AudricDenbroeder/LockerCracker/Rapport/DenbroederAudric_Rapport_PBE.pdf

Locker Cracker • June 2020

# Locker Cracker

Denbroeder Audric

HE2B - ISIB
audric96@gmail.com

Abstract

Mots clés— Cadenas, servomoteur, modèle 3D, OCR, tesseract, raspberry pi

I. Introduction

Pour le cours de projet et bureau d’étude
il m’a été demandé de réaliser un "hacker" de code de cadenas manuel. Ce genre de "robot" existant déjà pour un cadenas de type circulaire, je devais le réaliser sur un cadenas style européen, c’est-à-dire un simple cadenas avec 3-4 chiffres allant de 0 à 9. La façon de réaliser ce projet était libre, je n’avais aucune contrainte, si ce n’est d’utiliser un moteur. Je vais donc expliquer ici les différentes parties de projet qui sont les suivantes :
- L’électronique
- La modélisation 3D
- L’informatique

II. Electronique

Dès le début du projet un choix à du être posé : Comment faire pour tourner les chiffres du cadenas. Deux solutions ont été retenues. La première était d’utiliser un moteur utilisant des pinces pour tenir les chiffres et ensuite de faire tourner soit le cadenas soit les pinces pour que les chiffres tournent. Un peu comme un humain le ferait avec 2 doigts. La deuxième était d’utiliser un moteur avec une roue, que l’on mettrait juste à côté des chiffres, en faisant tourner la roue, la roue des chiffres tourneraient avec.
J’ai donc testé les deux solutions très rapidement après le début du projet. Finalement la deuxième solution était bien plus prometteuse que la première, les pinces n’avaient pas assez de couple disponible pour pouvoir tenir la roue du cadenas et la faire tourner en même temps. Cependant la roue n’avait aucun problème pour faire tourner les chiffres. Le moteur utilisé est le : FS5103R. La roue ayant été utilisée durant ce test est celle disponible avec le servomoteur.
Après avoir réalisé le modèle 3D (cela sera expliqué par la suite), un problème est survenu : L’adhésion de la roue à la roue du chiffre du cadenas. Celle-ci n’était pas parfaite ce qui avait pour conséquence de ne pas faire tourner les chiffres de manière constante. En effet cela se faisait parfois de la bonne façon on passait de 0 à 1 puis à 2, mais à d’autre moment l’adhésion n’étant plus parfaite, le chiffre passait de 2 à 4 ou simplement de 2 à 2.5 (La position milieu bloquant le cadenas).
Pour pallier ce problème mes professeurs m’ont suggéré l’idée d’utiliser une reconnaissance d’image pour lire les chiffres du cadenas. L’idée est que cela ne soit plus le servomoteur qui soit le cerveau et dicte la "cadence", à savoir faire du chiffre par chiffre. Mais plutôt la reconnaissance d’image, celle-ci regardera si il y’a un chiffre : Si non on demande au servomoteur d’avancer, si oui on vérifie le code.
Le projet qui se passait pour le moment sur Arduino utilisera donc une Raspberry Pi afin d’utiliser la camera de celle-ci pour la reconnaissance d’image (Qui sera expliqué plus en détail dans la partie informatique)
Pour faciliter la reconnaissance d’image un "flash" sera présent sur le modèle 3D, ce flash est constitué de LED. Les différentes parties de l’électronique est donc constitué de :
- Une raspberry pi
- Des leds
- Un servo-moteur (par rangée de chiffre)

1

III. Modélisation 3D

La modélisation 3D était une grande partie de ce projet car elle prenait beaucoup de temps durant le développement. En premier lui j’ai dû modéliser un caisson pour tenir le cadenas et le servomoteur proche l’un de l’autre, de façon à ce que la roue du servo soit collée à la roue des chiffres. Pour cela j’ai du aussi modéliser le cadenas :


Figure 1: Modèle 3D du cadenas

Ainsi que de modéliser le servomoteur et sa roue :


Figure 2: Modèle FS5103R

Pour avoir au final le 1er modèle :


Figure 3: Modèle FS5103R

C’est avec ce modèle que le problème d’adhésion a été détecté, en effet sans ce modèle il est impossible de savoir si l’adhésion est problématique. La cause est que l’on pourrait mal tenir le servomoteur et le cadenas l’un à côté de l’autre.

La réalisation de ce modèle a aussi permis de découvrir que la roue par défaut était beaucoup trop large, en effet celle-ci empiète sur l’une des deux autres rangée de chiffre lorsque mise sur celle du milieu. La solution a donc été de modéliser des nouvelles roues en 3D.

Malheureusement l’engrenage du servomoteur sur lequel la roue venait se fixer était impossible à reproduire en 3D, car beaucoup trop précis. Il a fallu donc être astucieux. Avec le servomoteur un kit est donné, celui-ci présente plusieurs éléments qui peuvent être ajouté à l’engrenage du servomoteur. On retrouve des petites roues, des barres horizontales, etc. Ce qui a été choisis est un morceau quadratique (Voir Figure 4), le but est donc de le modéliser en 3D et de creuser la roue modélisée en 3D avec ce modèle quadratique. Pour qu’une fois la roue imprimée l’on puisse mettre le morceau quadratique "dans" la roue et accrocher le tout au servomoteur(Voir figure 5 pour l’emboitement).

2

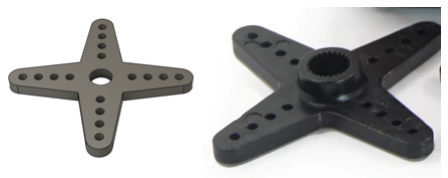
[picture p11: figure]

Figure 4: Modèle 3D et objet réel quadratique


Figure 5: Emboitement des modèles

Une fois tout cela imprimé et monté il fallait tester l’adhésion des roues en 3D au cadenas. De base nous voulions tester avec un matériau en résine car il avait la même consistance que du caoutchouc, cela n’a pas été possible, nous l’avons donc imprimer en PLA. Cependant l’adhésion était nulle, la roue du cadenas ne tournait pas du tout. Le but étant de se rapprocher de l’adhésion de la roue par défaut, à savoir une matière en caoutchouc, l’idée de mettre des élastiques autour est donc apparue, et cela a fonctionné. Pour faciliter la mise en place des élastiques sur la roue je l’ai modélisée à nouveau pour ajouter un U sur les bords (Voir Figure 6).

Figure 6: Rognage en U autour de la roue

Finalement un modèle 3D avec la caméra a du être réalisé, celle-ci devait être pile devant le cadenas à une distance de focus raisonnable d’environ 7cm. Ce premier modèle a donc été fait :

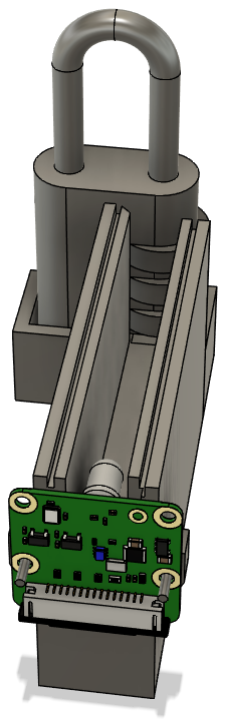
[picture p12: figure]

Figure 7: 1er modèle 3D pour la caméra

Ce modèle ne disposait que d’une seule LED, ce qui n’était pas suffisant pour que l’OCR détecte les chiffres, trois autres ont donc été ajoutées autour de la caméra. Une attention particulière au futur modèle a été apporté, la roue risquant de se coincer sur le modèle on a dû en couper le mur, ce pourquoi il est en diagonale.

3

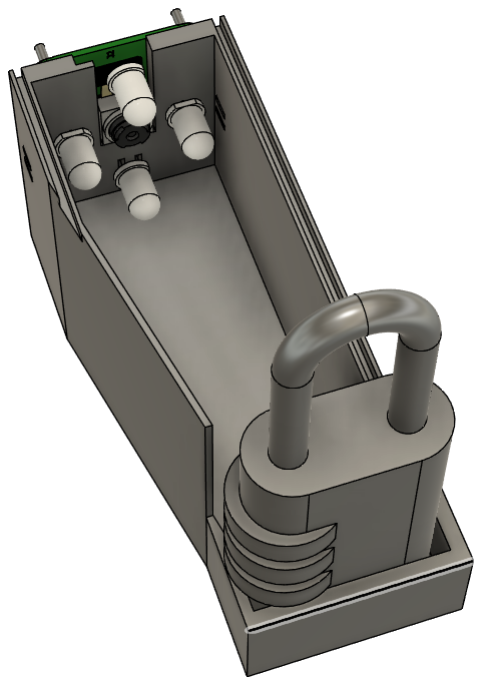
[picture p13: figure]

Figure 8: 2eme modèle 3D pour la caméra

Et finalement le modèle final, où l’on retrouve tout, c’est à dire, la caméra, le servo moteur avec sa roue, le cadenas, etc.


Figure 9: Dernier modèle en 3D

Voici aussi ce modèle final en réel, avec le cadenas, le servomoteur et aussi le couvercle :


Figure 10: Dernier modèle en 3D

IV. Informatique

De base, je n’avais pas beaucoup de chose à faire pour l’informatique, si ce n’est coder le code pour contrôler le servomoteur. Comme tous les servomoteurs, il est commandé par des impulsions et des délais, il y a peu de documentation à son sujet, je savais juste qu’il était commandable entre 500us et 2500us. Si l’on sait qu’un servomoteur à 3 états, à savoir une rotation dans le sens horaire, une autre dans le sens anti horaire et un état "stop". On peut supposer que ces 3 états ont une impulsion différente et séparé, j’en ai conclu qu’ils étaient à 1000us, 1500us et 2000us. Un autre document (voir bibliographie) confirmait ma supposition. Un code simple a donc été fait pour contrôler le servomoteur sur arduino.
Par la suite, l’idée de rajouter une reconnaissance d’image a été amenée, l’arduino a été abandonné et la Raspberry Pi a pris sa place. Celle-ci pouvait aussi commander le servomoteur tout en ayant une caméra et avait accès à la reconnaissance d’image via tesseract-ocr. Tout cela a été codé en python, l’idée est la suivante : prendre une photo avec la caméra, faire du traitement d’image pour faciliter la lecture de l’OCR (Optical Character Recognition), l’OCR lit le chiffre après traitement, et finale-

4

ment commande du servomoteur en fonction de la lecture.
La caméra est utilisée sur python via la librairie picamera, le traitement d’image se fait avec OpenCv, l’OCR utilise pytesseract (un package qui permet d’utiliser tesseract-ocr sur python), pour le contrôle des Led (flash) et du servomoteur la libraire RPi.GPIO sera utilisée. J’ai passé beaucoup de temps sur le traitement d’image, ai essayé de la traiter pour que l’OCR puisse lire les chiffres plus facilement. En changeant le contraste, en faisant du treshold, en flouant l’image, en utilisant des systèmes propres à OpenCV comme de l’érosion (éroder les pixels blancs sur l’image), parfois tout en même temps. Malheureusement, rien de cela n’a été concluant. Voici un exemple de ce que je faisais lorsque je n’avais que une seule Led pour servir de flash :

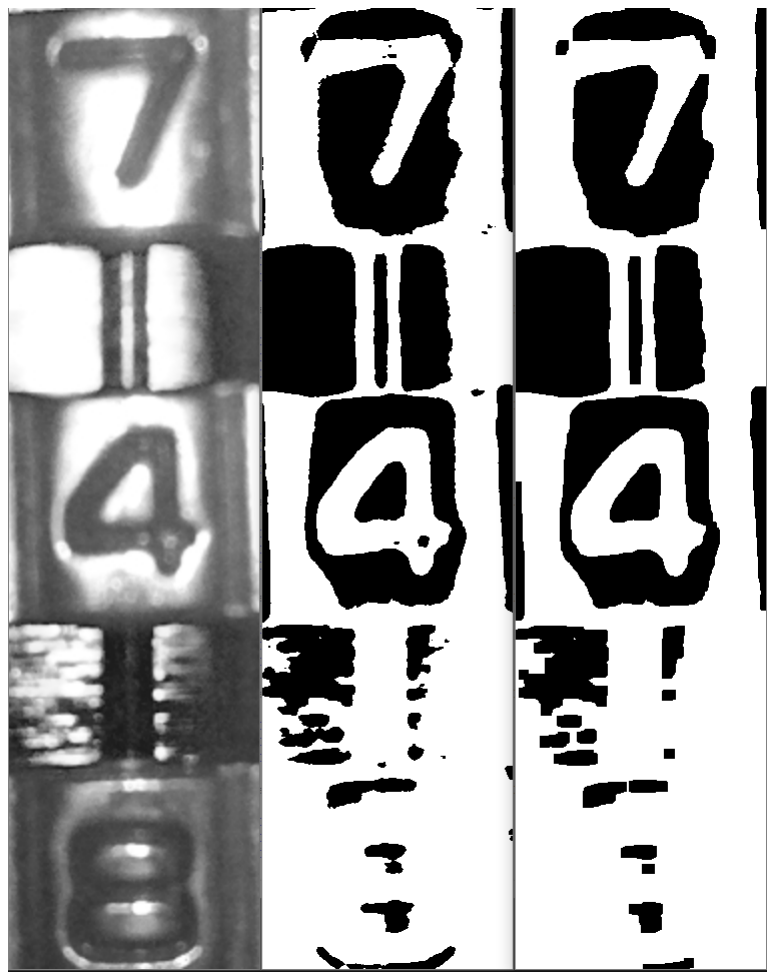
[picture p14: figure]

Figure 11: Exemple traitement d’image

Premièrement, on remarque qu’un même traitement ne fonctionne pas pour les différentes rangées, le 8 devient illisible contrairement au 4 et au 7. Pour pallier ce problème, j’ai rajouté plus de LED pour le flash. Cependant, cela n’a pas réglé le problème général, à savoir que l’OCR ne sait pas reconnaître le caractère parfaitement réalisé (dans cette image-ci le 4).

Après discussion avec mes professeurs il est ressorti que le mieux serait d’entraîner l’IA (Intelligence Artificielle), contrôlant l’OCR, avec les images du cadenas. Pour que celle-ci puisse tout simplement mieux reconnaître les caractères sans même devoir faire beaucoup de traitement d’image. Cependant, ceci dépasse le cadre de l’électronique et se rapproche plus de l’informatique. Et à ce moment-là, le temps étant proche de la fin de l’année scolaire, on trouvait qu’il était mieux que je finalise tout le reste, à savoir le modèle 3D final, et les codes pour tout contrôler.

V. Améliorations possibles pour

la suite

Je vais expliquer ici les différentes améliorations possibles si le projet est repris une année suivante.

### I. Entrainement de l’IA pour l’OCR

Comme expliqué dans la section informatique, la meilleure chose possible pour que l’OCR puisse détecter les chiffres est de l’entraîner. Cela est probablement la solution la plus efficace actuellement. Cependant, il ne faudra pas négliger le traitement d’image qui devra quand même être un minimum présent.

### II. Servomoteur avec un couple plus faible

Le servomoteur utilisé est le FS5103R, celui-ci a un couple de 3kg.cm/41.74oz.in. Il a suffisamment de couple pour pouvoir tourner les chiffres du cadenas, cependant il prends beaucoup de place. Ce que j’ai réalisé ne contient qu’un seul servomoteur, mais normalement il en faut trois. En essayant de faire un modèle avec trois servomoteurs, je me suis rendu compte que c’était extrêmement compliqué car ils prennent beaucoup de place chacun. L’idée serait donc de vérifier si un servomoteur avec un couple plus faible, 1.5kg/cm par exemple, arrive à faire tourner les chiffres du cadenas. Parce que ceux-ci prendront moins de place et

5

faciliteraient donc la modélisation d’un modèle ayant trois servomoteurs.

VI. Conclusion

En conclusion, la partie électronique est finie, la Raspberry Pi sert de cerveau pour le projet. Elle commande un servomoteur ainsi que des led et une caméra pour la reconnaissance d’image.
Plusieurs modèles 3D ont été réalisé pour convenir au mieux au besoin du projet et un boîtier final a pu être réalisé dans les délais attendu. Une roue spécialisée a aussi été créer afin de pouvoir faire tourner le cadenas sans problème.
Finalement, la reconnaissance d’image n’a pas été concluante, celle-ci n’est pas suffisante pour reconnaître les caractères présents sur le cadenas malgré un tas de traitement d’image. Cependant, la solution d’entraîner une IA afin d’arriver à la reconnaissance est prometteuse.

References

[1] Datasheet FS5103R, consulté en Février-Juin
https://media.digikey.com/pdf/data%20sheets/adafruit%20pdfs/154_web.pdf (https://media.digikey.com/pdf/data%20sheets/adafruit%20pdfs/154_web.pdf)
[2] Lien Github du projet avec toutes les ressources
https://github.com/
AudricDenbroeder/LockerCracker (https://github.com/AudricDenbroeder/LockerCracker)

6
