AudricDenbroeder/LockerCracker/Rapport/quadthingmodel.PNG

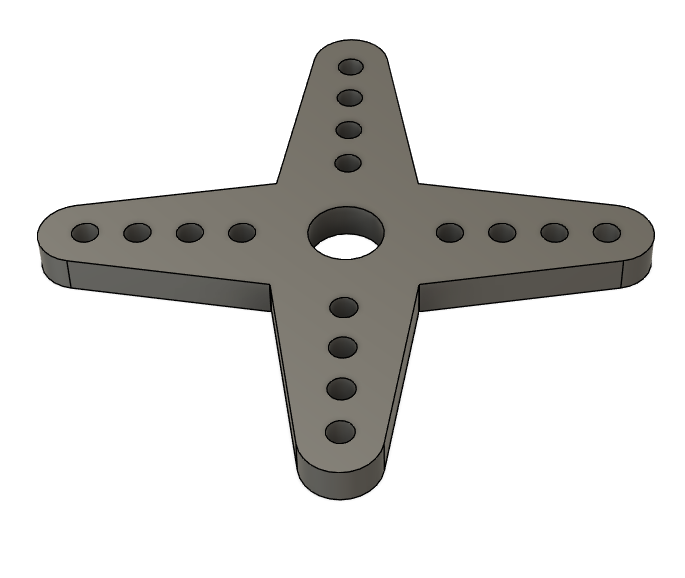
Rapport/quadthingmodel.PNG
