AudricDenbroeder/LockerCracker/Rapport/quadthingreal.PNG

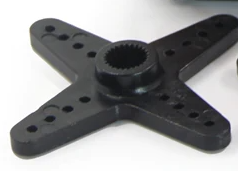
Rapport/quadthingreal.PNG
