AudricDenbroeder/LockerCracker/3D models/StructureCase.step

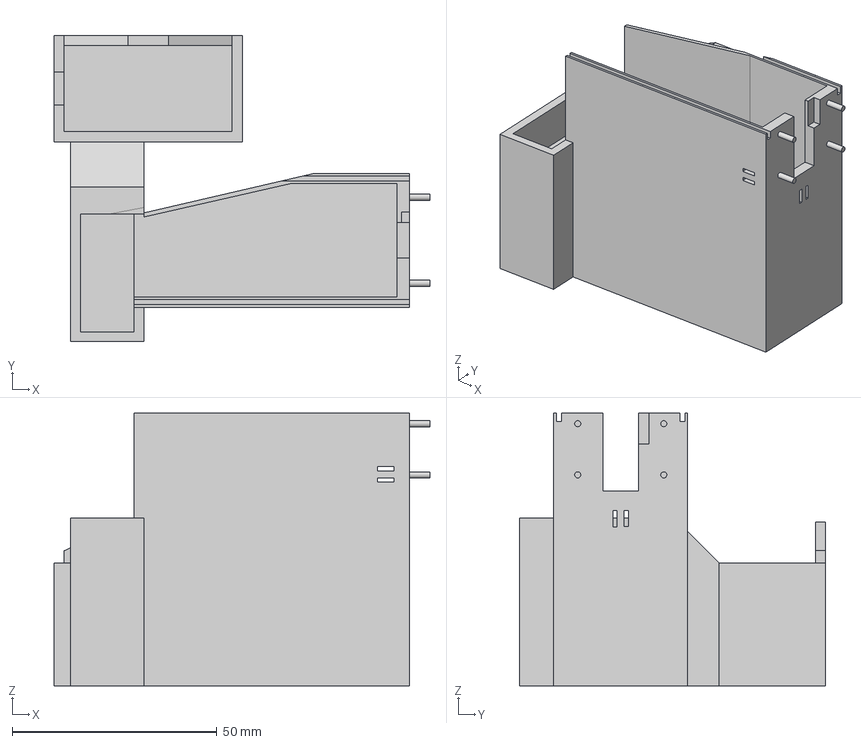
[picture p17: CAD file, 2020-06-06]
3D models/StructureCase.step
91.8 x 74.8 x 66.6 mm
