AudricDenbroeder/LockerCracker/3D models/StructureTop.step

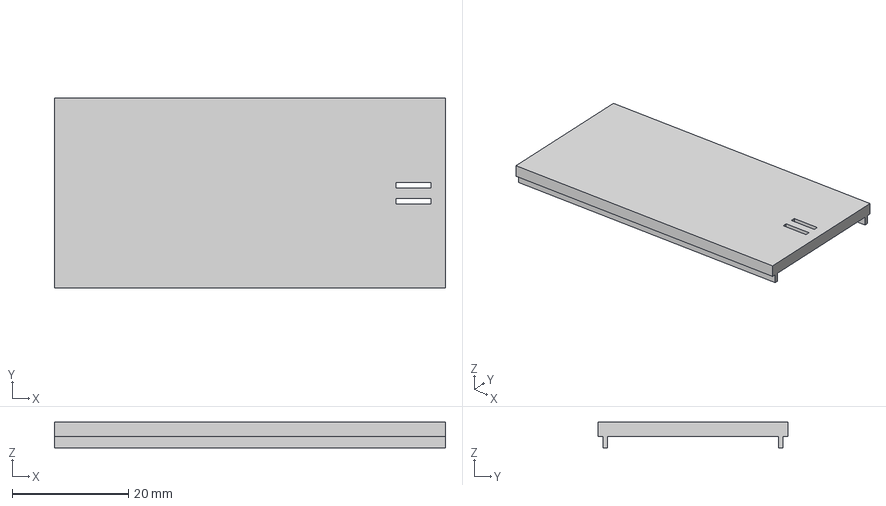
[picture p18: CAD file, 2020-06-06]
3D models/StructureTop.step
67.3 x 32.7 x 4.40 mm
