AudricDenbroeder/LockerCracker/3D models/WheelsFS5103R.step

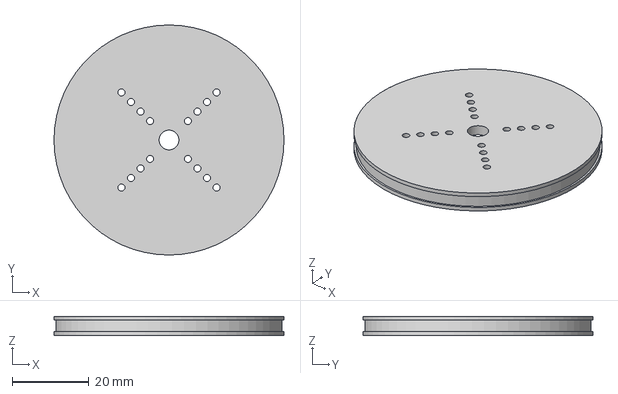
[picture p19: CAD file, 2020-06-06]
3D models/WheelsFS5103R.step
60.0 x 60.0 x 5.00 mm
