AudricDenbroeder/LockerCracker/(list of files, cad)

Other CAD files:
3D models/StructureCase.f3d
3D models/StructureTop.f3d
3D models/WheelsFS5103R.f3d
