AudricDenbroeder/LockerCracker/(threads)

Thread 1 (2020-06-06):

Doesn't work

AnthonyPapageo, 2020-06-06:
Hi, my raspberry blowed up with your code

Closed 2020-06-06.
