AudricDenbroeder/LockerCracker/(commit log)

2020-06-06 Add models
    [StructureCase.f3d, StructureCase.step, StructureTop.f3d, StructureTop.step, WheelsFS5103R.f3d, WheelsFS5103R_Wheels1.05 v2.step]
2020-06-06 Correction Models
    [WheelsFS5103R.step]
